PhoenixbornTech/DigiBadgeV2/Datasheets/TS-1501.jpg

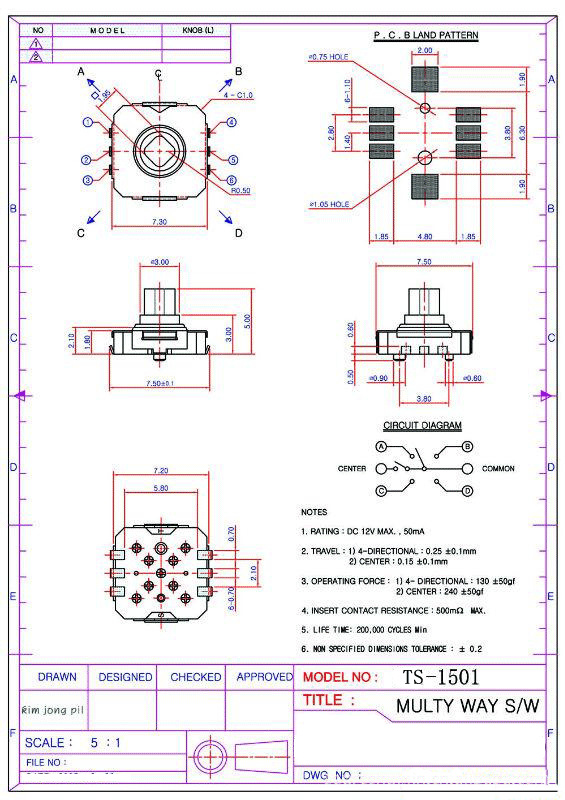
Datasheets/TS-1501.jpg
