PhoenixbornTech/DigiBadgeV2/Datasheets/DigiBadge V2 BOM.pdf

DigiBadge V2 R3D BOM

Item | Purpose | Quantity | Reference
RC0805JR-0710KL | Reset Resistor | 1 | R1
CL21F104ZBCNNNC FTDI Capacitor | 1 | C1
ATMEGA328-AU | | 1 | U1
TFP09-2-12B | Micro SD Reader | 1 | U4 | 10-TFP09-2-12B.pdf
TS-1501 | Navigation Switch | 1 | SW1
JD-T18003-T01 | Display Screen | 1 | U2
JS202011SCQN | Power Switch | 1 | POWER
2468 | Battery Case | 1 | B1

Datasheet File
Pyu-RC_Group_51_RoHS_L_04.pdf CL_Series_MLCC_ds
Microcontroller | Atmel-8-bit-AVR-Microcontroller.pdf
| TS-1501.jpg
| JD-T1800.pdf ST7735R_V0.2.pdf
| js.pdf
| 2468.pdf
