PhoenixbornTech/DigiBadgeV2/V2_Mini_R3D Schematic.pdf

2 R1
10kΩ

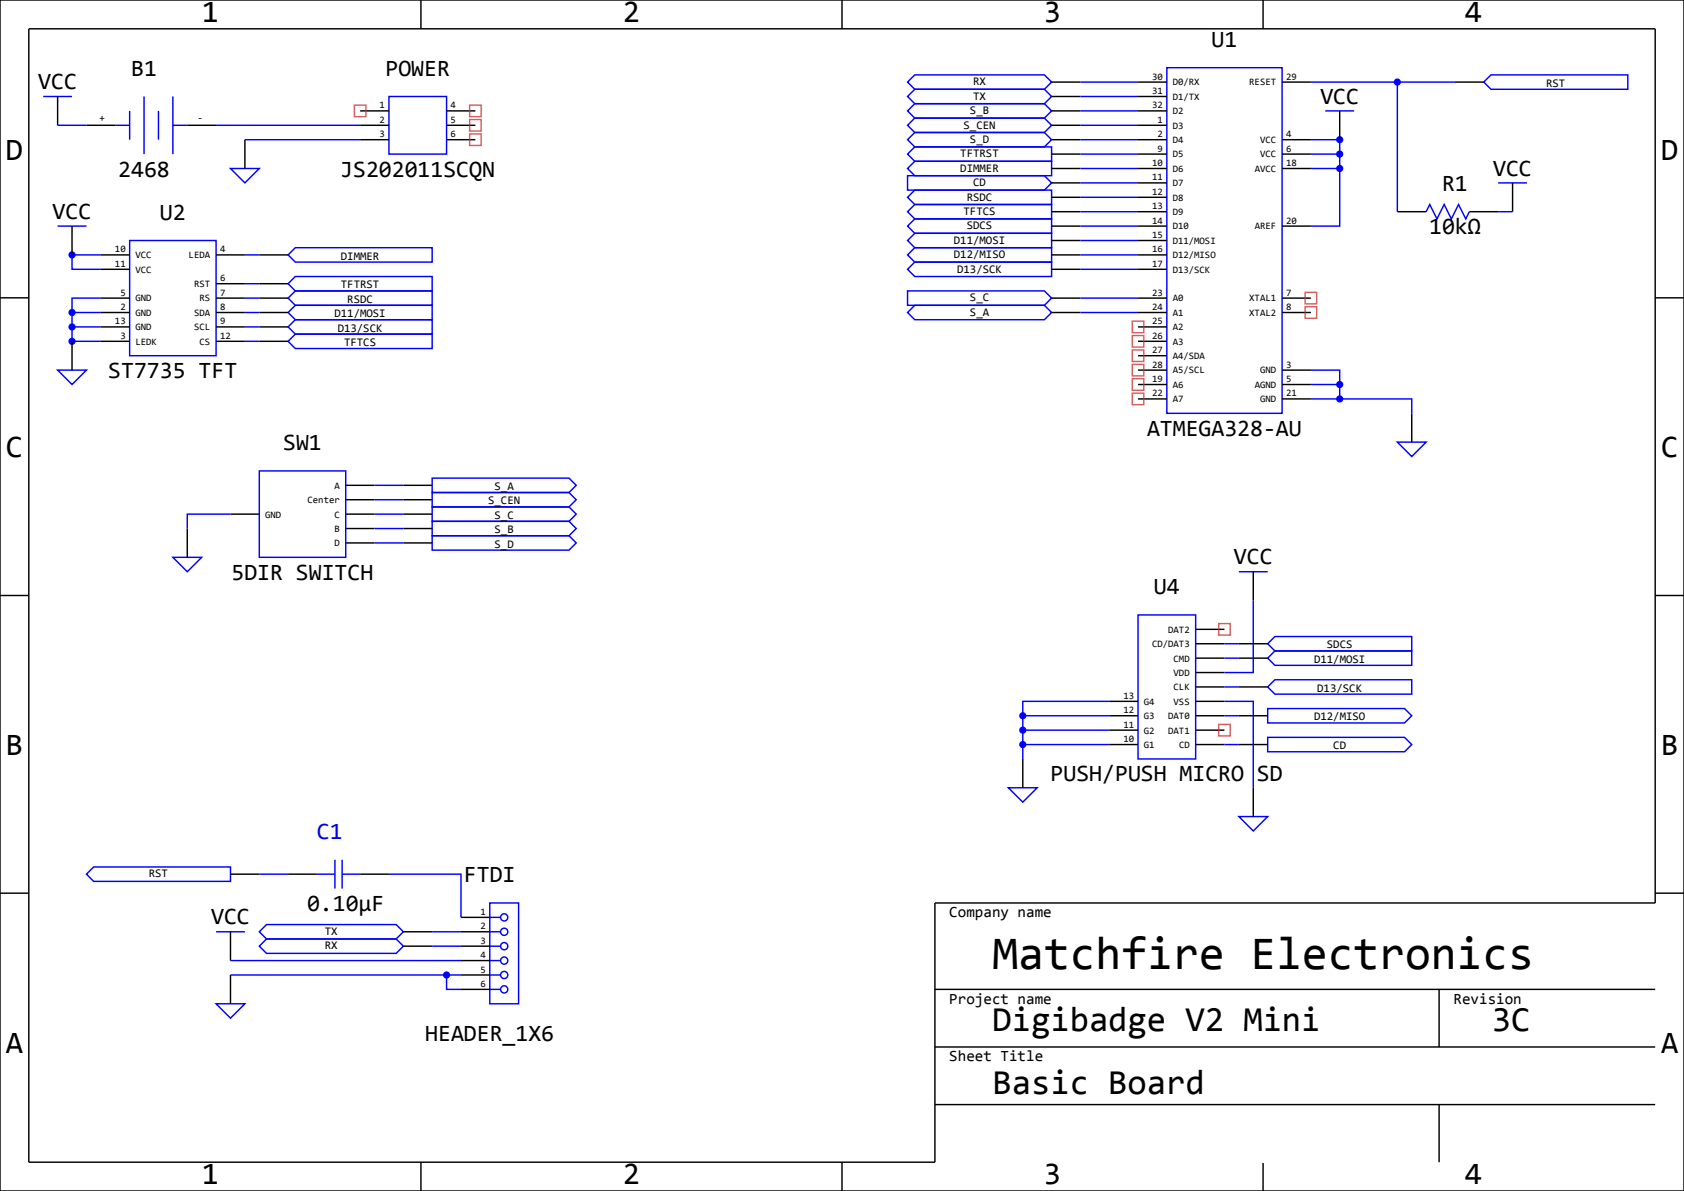
[picture p2: page 1]

Company name
Matchfire Electronics
Project name Digibadge V2 Mini
Basic Board
