PhoenixbornTech/DigiBadgeV2/V2_Mini_R3C Schematic.pdf

2 R1
10kΩ

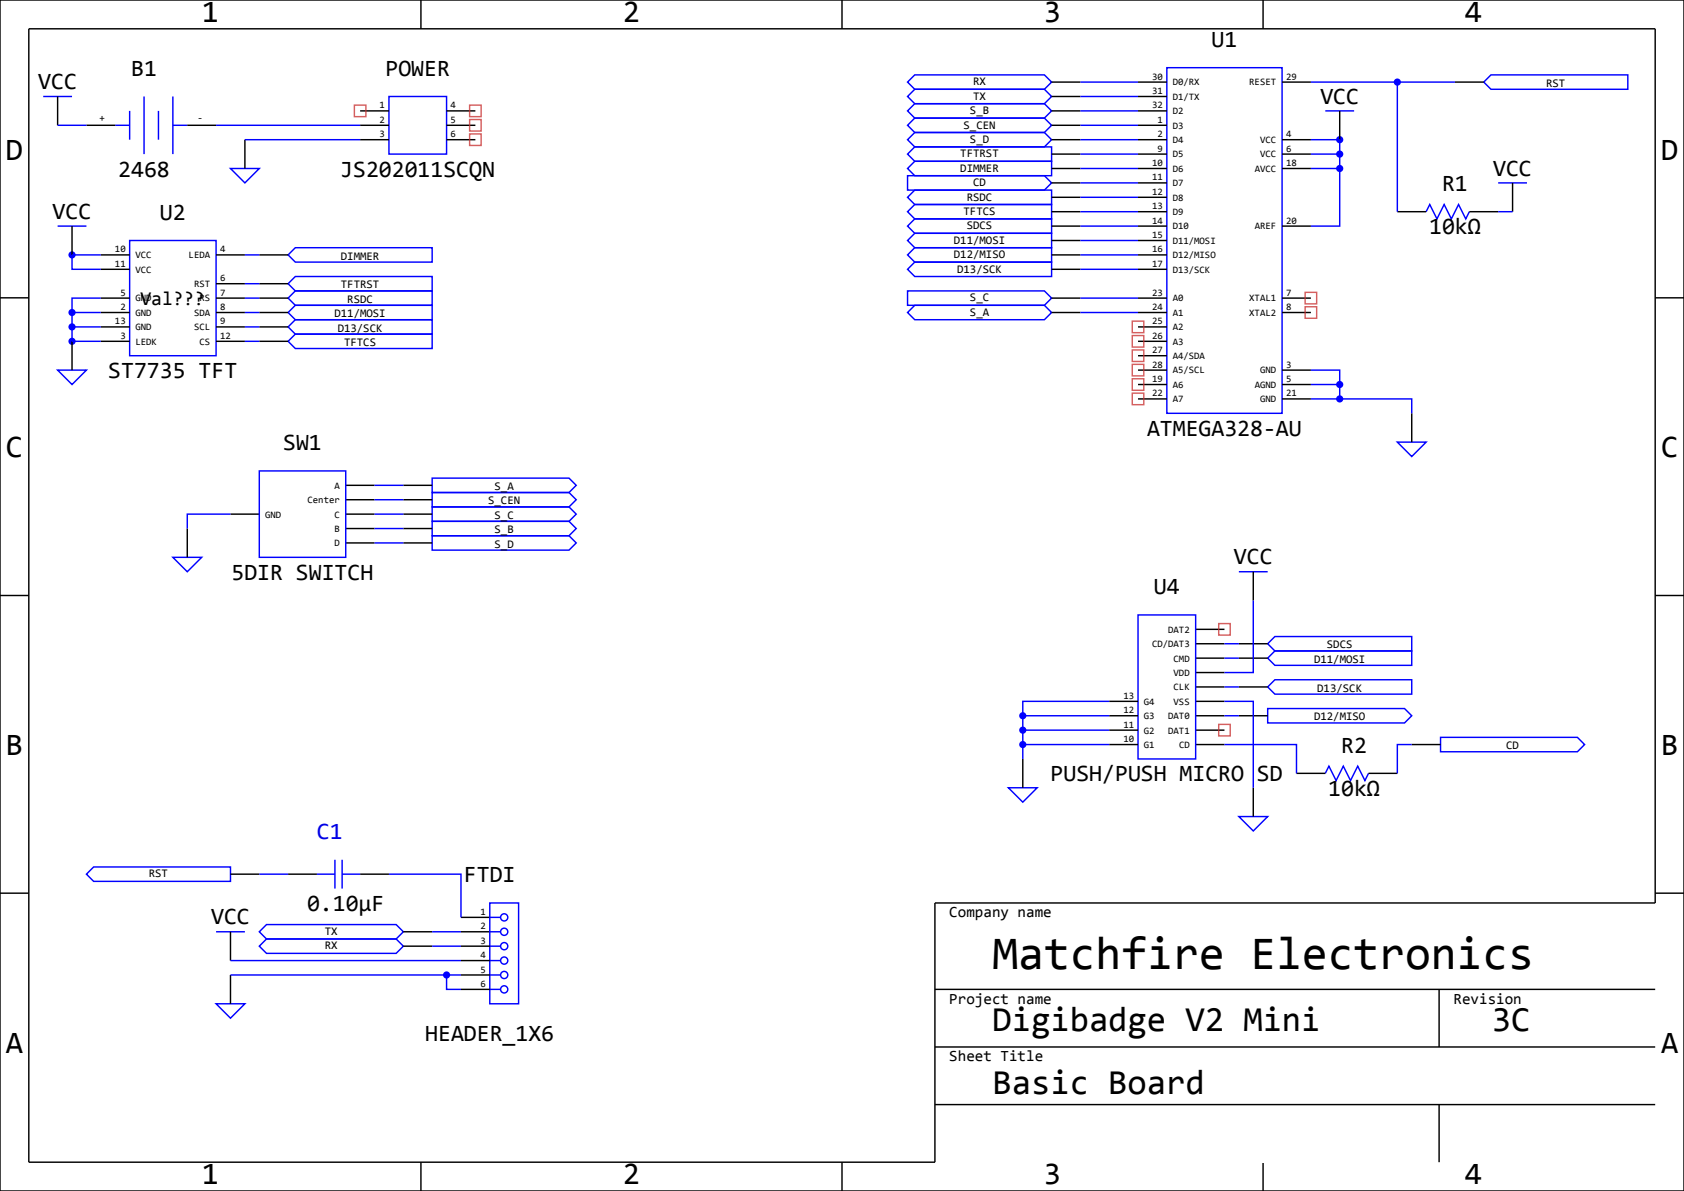
[picture p3: page 1]

Company name
Matchfire Electronics
Project name Digibadge V2 Mini
Basic Board
