PhoenixbornTech/DigiBadgeV2/(commit log)

2016-05-31 Initial Commit
    Added schematics and .cad file, updated README
2016-06-02 Added code
    Added code for the DigiBadge V2. No guarantee that it'll work with the
    final version as it's designed for the prototype which is (at writing)
    still being manufactured.
2016-06-04 Fixed brightness comment errors
    V1 badge had 10 levels of brightness (1-10), V2 has 26 (0-26). Comments
    now up to date with code.
    [digibadge_v2.ino]
2016-06-07 Updated board, Updated program
    Code changes:
    -S_LEFT initializing properly (Was commented out due to early prototype
    code)
    -Removing SD card will now properly draw the badge and won't stick on
    the "Returning to badge mode" screen.
    -Added support for SD power control pin. If SD_CD (Card Detect) is HIGH,
    then there is no card in the slot and SD_POW is low. Once SD_CD reads
    LOW and indicates there's a SD card, SD_POW is turned HIGH, and then the
    card read is attempted.
    PCB:
    -Removed SD_CD's 10k resistor. This was an attempt to fix a problem that
    was completely different. Problem is when SD card is inserted, the whole
    device resets. Fairly confident this is a temporary short between VCC
    and Gro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
    [digibadge_v2.ino]
2016-06-07 Removed SD power via board
    ATMega doesn't provide enough power via pins to safely power the SD
    card. In the interest of avoiding Bad Things, this change has been
    removed.
    [digibadge_v2.ino]
2016-06-11 Added voltage check, low battery check
    Added a function to check VCC voltage.
    Added calls to determine if battery is low, and display marker
    appropriately.
    Fixed max files and name length of file list to work with current code.
    [digibadge_v2.ino]
2016-06-16 SD Card/Voltage Reading bugfixes
    Fixed issue where voltage was not being read correctly.
    Fixed issue where, upon inserting an SD card, the badge would not return
    to being a badge.
    Fixed issue where, upon inserting an SD card, filenames would simply be
    added to any previous files listed.
    [digibadge_v2.ino]
2016-07-04 Updated low power detection and handling
    Changed low voltage alert to 2.65v
    Device now sleeps/shuts down at 2.5v
    Button detection changed from 1/4 second to 1/5 second.
2016-07-16 Added datasheets
    Added datasheets for all components and a Bill of Materials.
2016-07-23 Updated datasheets
    Unzipped Datasheets file into folder.
    Improved BOM file
    Added datasheet for power switch.
2016-07-23 Added battery pack datasheet
    Added battery pack to BOM
    Added battery pack datasheet
2017-02-22 Fix for Slideshow
    Accidentally left out the reset counter for the slideshow. Thanks
    Prismatic!
    [digibadge_v2.ino]
